Tedgin254/ENERGY-METER/README.md

# ENERGY-METER
ESP32-based smart energy monitoring system that measures voltage, current, power, and energy consumption in real time. Features Wi-Fi connectivity for cloud data logging and dashboard visualization. Ideal for home or industrial power management, energy efficiency tracking, and IoT-based smart grid applications.
energy meter
