Tedgin254/ENERGY-METER/02_Schematic_Design/energy meter.kicad_sch

## KiCad design 02_Schematic_Design/energy meter.kicad_sch (2025-10-16)

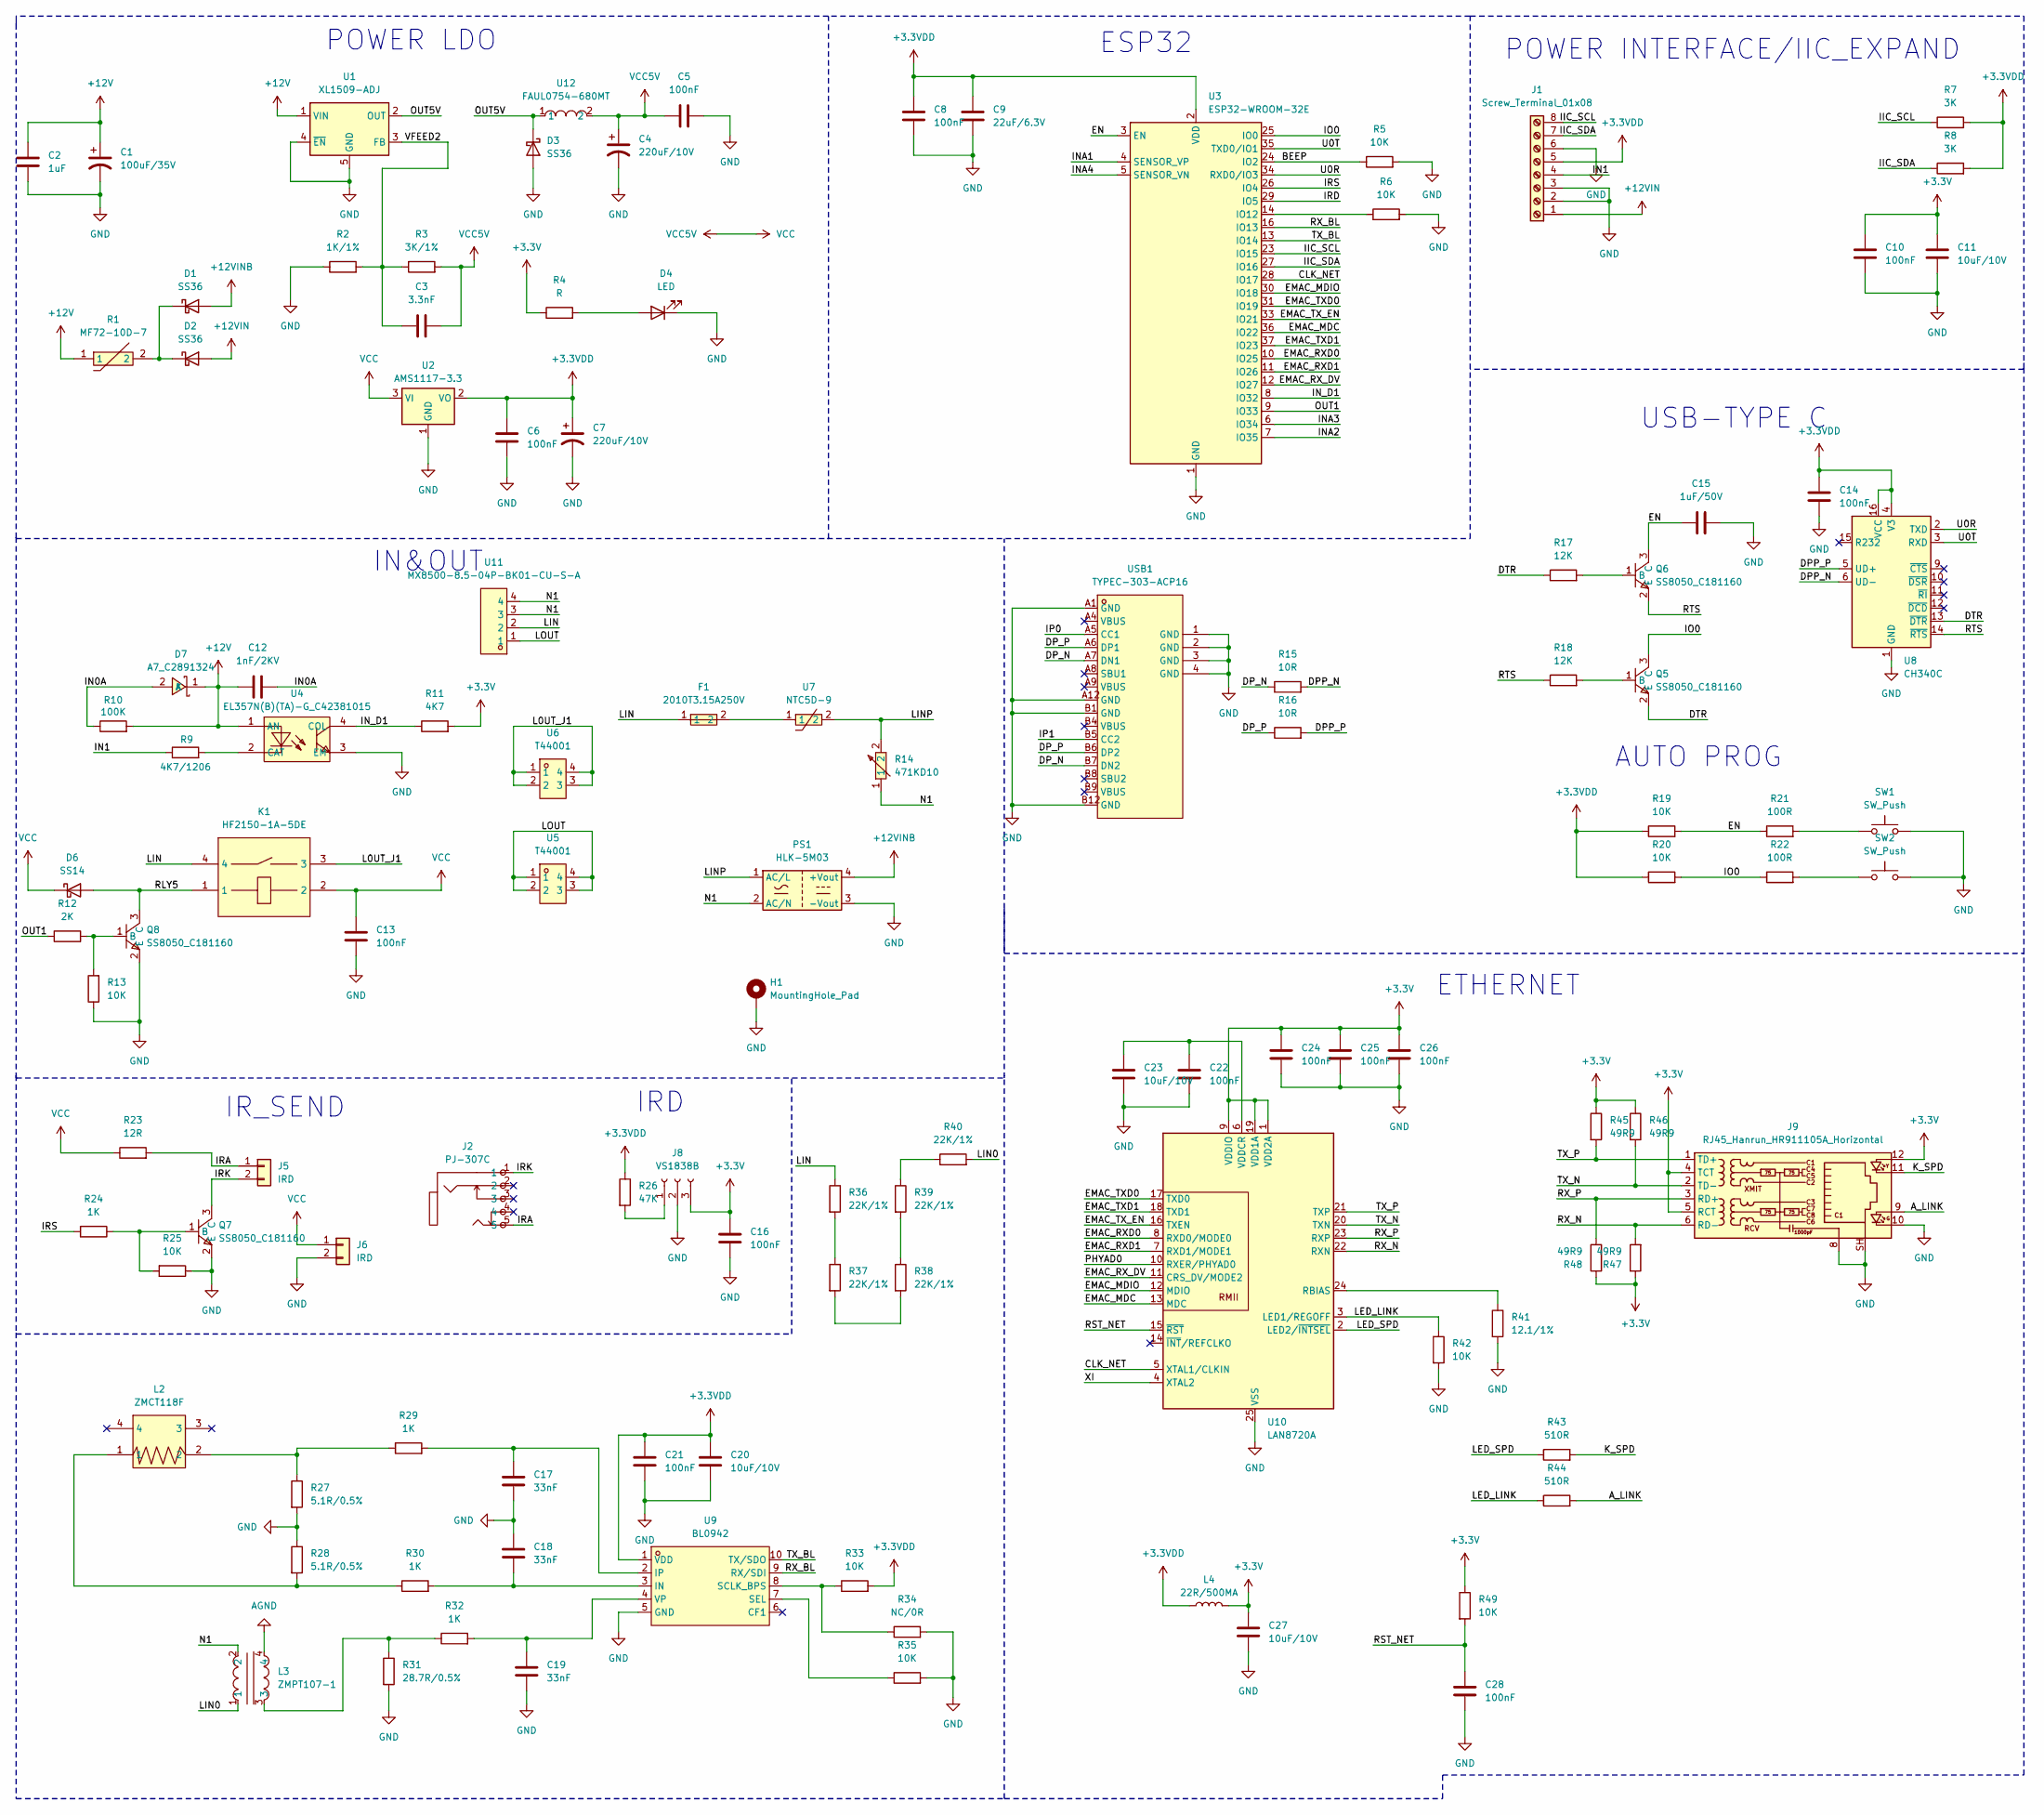
[picture p1: schematic energy meter.kicad_sch]

Parts:
C1: 100uF/35V; CP_Elec_6.3x5.7
C2: 1uF; C_0603_1608Metric_Pad1.08x0.95mm_HandSolder
C3: 3.3nF; C_0603_1608Metric
C4, C7: 220uF/10V; CP_Elec_6.3x5.7
C5, C6, C8, C10, C13, C14, C16, C21, C22, C24, C25, C26, C28: 100nF; C_0603_1608Metric
C9: 22uF/6.3V; C_0805_2012Metric
C11, C20, C23, C27: 10uF/10V; C_0805_2012Metric
C12: 1nF/2KV; C_1206_3216Metric
C15: 1uF/50V; C_0805_2012Metric
C17, C18, C19: 33nF; C_0603_1608Metric
D1, D2, D3: SS36; D_SMA
D4: LED; LED_0402_1005Metric
D6: SS14; D_SMA
D7: A7_C2891324; SOD-123FL_L2.8-W1.8-LS3.7-RD; LCSC Part C2891324
F1: 2010T3.15A250V; FUSE-TH_L8.5-W4.0-P5.08-D0.6; LCSC Part C354904
H1: MountingHole_Pad; MountingHole_2.7mm_M2.5_Pad
J1: Screw_Terminal_01x08; TerminalBlock_Phoenix_MKDS-3-8-5.08_1x08_P5.08mm_Horizontal
J2: PJ-307C; AUDIO-TH_PJ307C; LCSC Part C16684
J5, J6: IRD; TerminalBlock_Phoenix_PT-1,5-2-5.0-H_1x02_P5.00mm_Horizontal
J8: VS1838B; PinSocket_1x03_P2.54mm_Vertical
J9: RJ45_Hanrun_HR911105A_Horizontal
K1: HF2150-1A-5DE; RELAY-TH_HF2150-1A; LCSC Part C87365
L2: ZMCT118F; XFMR-TH_ZMCT118F; LCSC Part C173174
L3: ZMPT107-1; XFMR-TH_ZMPT107-1; LCSC Part C125191
L4: 22R/500MA; L_1008_2520Metric
PS1: HLK-5M03; Converter_ACDC_Hi-Link_HLK-5Mxx
Q5, Q6, Q7, Q8: SS8050_C181160; SOT-23-3_L2.9-W1.6-P1.90-LS2.8-BR; LCSC Part C181160
R1: MF72-10D-7; RES-TH_L8.5-W5.5-P5.00-D0.6-S5.50; LCSC Part C9176
R2: 1K/1%; R_0603_1608Metric
R3: 3K/1%; R_0603_1608Metric
R4: R; R_0603_1608Metric
R5, R6, R13, R19, R20, R25, R33, R35, R42, R49: 10K; R_0805_2012Metric
R7, R8: 3K; R_0603_1608Metric
R9: 4K7/1206; R_0805_2012Metric
R10: 100K; R_0805_2012Metric
R11: 4K7; R_0603_1608Metric
R12: 2K; R_0603_1608Metric
R14: 471KD10; RES-TH_L12.5-W4.8-P7.50-D1.2-S3.40; LCSC Part C78346
R15, R16: 10R; R_0603_1608Metric
R17, R18: 12K; R_0805_2012Metric
R21, R22: 100R; R_0603_1608Metric
R23: 12R; R_0603_1608Metric
R24, R29, R30, R32: 1K; R_0603_1608Metric
R26: 47K; R_0603_1608Metric
R27, R28: 5.1R/0.5%; R_0603_1608Metric
R31: 28.7R/0.5%; R_0603_1608Metric
R34: NC/0R; R_0603_1608Metric
R36, R37, R38, R39, R40: 22K/1%; R_0805_2012Metric
R41: 12.1/1%; R_0805_2012Metric
R43, R44: 510R; R_0603_1608Metric
R45, R46, R47, R48: 49R9; R_0603_1608Metric
SW1, SW2: SW_Push; SW_Tactile_SPST_NO_Straight_CK_PTS636Sx25SMTRLFS
U1: XL1509-ADJ; SOIC-8_3.9x4.9mm_P1.27mm
U2: AMS1117-3.3; SOT-223-3_TabPin2
U3: ESP32-WROOM-32E; ESP32-WROOM-32D
U4: EL357N(B)(TA)-G_C42381015; OPTO-SMD-4_L4.4-W4.1-P2.54-LS7.0-TL; LCSC Part C42381015
U5, U6: T44001; CONN-TH_T44001; LCSC Part C481447
U7: NTC5D-9; RES-TH_L11.0-W5.5-P7.50-D0.8-S4.70; LCSC Part C702818
U8: CH340C; SOIC-16_3.9x9.9mm_P1.27mm
U9: BL0942; SSOP-10_L4.9-W3.9-P1.00-LS6.0-BL; LCSC Part C2837510
U10: LAN8720A; VQFN-24-1EP_4x4mm_P0.5mm_EP2.5x2.5mm_ThermalVias
U11: MX8500-8.5-04P-BK01-CU-S-A; CONN-TH_4P-P8.50_MX8500-8.5-04P-GN01-CU-S-A; LCSC Part C5188508
U12: FAUL0754-680MT; IND-SMD_L7.9-W7.2; LCSC Part C5298270
USB1: TYPEC-303-ACP16; USB-C-SMD_TYPEC-303-ACP16; LCSC Part C720628

Connections:
+3.3V: C10.1, C11.1, C16.1, C24.1, C25.1, C26.1, C27.1, J8.3, J9.4 (TCT), J9.5 (RCT), J9.12, L4.2, R4.1, R11.2, R45.1, R46.1, R47.1, R48.1, R49.1, U10.1 (VDD2A), U10.9 (VDDIO), U10.19 (VDD1A)
+3.3VDD: C6.1, C7.1, C8.1, C9.1, C14.1, C20.1, C21.1, J1.5, L4.1, R7.2, R8.2, R19.1, R20.1, R26.1, R33.2, U2.2 (VO), U3.2 (VDD), U8.4 (V3), U8.16 (VCC), U9.1 (VDD)
+12V: C1.1, C2.1, C12.1, D7.1 (K), R1.1, R10.2, U1.1 (VIN), U4.1 (AN)
+12VIN: D2.2 (A), J1.1
+12VINB: D1.2 (A), PS1.4 (+Vout)
AGND: L3.4
A_LINK: J9.9, R44.2
BEEP: R5.1, U3.24 (IO2)
CLK_NET: U3.28 (IO17), U10.5 (XTAL1/CLKIN)
DPP_N: R15.2, U8.6 (UD-)
DPP_P: R16.2, U8.5 (UD+)
DP_N: R15.1, USB1.A7 (DN1), USB1.B7 (DN2)
DP_P: R16.1, USB1.A6 (DP1), USB1.B6 (DP2)
DTR: Q5.2 (E), R17.1, U8.13 (~DTR)
EMAC_MDC: U3.36 (IO22), U10.13 (MDC)
EMAC_MDIO: U3.30 (IO18), U10.12 (MDIO)
EMAC_RXD0: U3.10 (IO25), U10.8 (RXD0/MODE0)
EMAC_RXD1: U3.11 (IO26), U10.7 (RXD1/MODE1)
EMAC_RX_DV: U3.12 (IO27), U10.11 (CRS_DV/MODE2)
EMAC_TXD0: U3.31 (IO19), U10.17 (TXD0)
EMAC_TXD1: U3.37 (IO23), U10.18 (TXD1)
EMAC_TX_EN: U3.33 (IO21), U10.16 (TXEN)
EN: C15.1, Q6.3 (C), R19.2, R21.1, U3.3 (EN)
GND: C1.2, C2.2, C4.2, C5.2, C6.2, C7.2, C8.2, C9.2, C10.2, C11.2, C13.2, C14.2, C15.2, C16.2, C17.2, C18.1, C19.2, C20.2, C21.2, C22.2, C23.2, C24.2, C25.2, C26.2, C27.2, C28.2, D3.2 (A), D4.1 (K), H1.1, J1.2, J1.3, J1.6, J6.2, J8.2, J9.8, J9.10, J9.SH, PS1.3 (-Vout), Q7.2 (E), Q8.2 (E), R2.1, R5.2, R6.2, R13.1, R25.1, R27.2, R28.1, R31.2, R34.2, R35.2, R41.2, R42.2, SW1.2, SW2.2, U1.4 (~EN), U1.5 (GND), U1.6 (GND), U1.7 (GND), U1.8 (GND), U2.1 (GND), U3.1 (GND), U3.15 (GND), U3.38 (GND), U3.39 (GND), U4.3 (EM), U8.1 (GND), U9.5 (GND), U10.25 (VSS), USB1.1 (GND), USB1.2 (GND), USB1.3 (GND), USB1.4 (GND), USB1.A1 (GND), USB1.A12 (GND), USB1.B1 (GND), USB1.B12 (GND)
IIC_SCL: J1.8, R7.1, U3.23 (IO15)
IIC_SDA: J1.7, R8.1, U3.27 (IO16)
IN0A: C12.2, D7.2 (A), R10.1
IN1: J1.4, R9.1
INA1: U3.4 (SENSOR_VP)
INA2: U3.7 (IO35)
INA3: U3.6 (IO34)
INA4: U3.5 (SENSOR_VN)
IN_D1: R11.1, U3.8 (IO32), U4.4 (COL)
IO0: Q5.3 (C), R20.2, R22.1, U3.25 (IO0)
IP0: USB1.A5 (CC1)
IP1: USB1.B5 (CC2)
IRA: J2.5, J5.1, R23.2
IRD: U3.29 (IO5)
IRK: J2.1, J5.2, Q7.3 (C)
IRS: R24.2, U3.26 (IO4)
K_SPD: J9.11, R43.2
L0UT_J1: K1.3, U6.1, U6.2, U6.3, U6.4
LED_LINK: R42.1, R44.1, U10.3 (LED1/REGOFF)
LED_SPD: R43.1, U10.2 (LED2/~INTSEL)
LIN: F1.1, K1.4, R36.1, U11.2
LIN0: L3.1, R40.2
LINP: PS1.1 (AC/L), R14.2, U7.2
LOUT: U5.1, U5.2, U5.3, U5.4, U11.1
N1: L3.2, PS1.2 (AC/N), R14.1, U11.3, U11.4
unnamed: C17.1, R29.2, U9.2 (IP)
unnamed: C18.2, R30.2, U9.3 (IN)
unnamed: C19.1, R32.2, U9.4 (VP)
unnamed: C22.1, C23.1, U10.6 (VDDCR)
unnamed: D1.1 (K), D2.1 (K), R1.2
unnamed: D4.2 (A), R4.2
unnamed: F1.2, U7.1
unnamed: J8.1, R26.2
unnamed: L2.1, R28.2, R30.1
unnamed: L2.2, R27.1, R29.1
unnamed: L3.3, R31.1, R32.1
unnamed: Q5.1 (B), R18.2
unnamed: Q6.1 (B), R17.2
unnamed: Q7.1 (B), R24.1, R25.2
unnamed: Q8.1 (B), R12.2, R13.2
unnamed: R6.1, U3.14 (IO12)
unnamed: R9.2, U4.2 (CAT)
unnamed: R21.2, SW1.1
unnamed: R22.2, SW2.1
unnamed: R33.1, R34.1, U9.8 (SCLK_BPS)
unnamed: R35.1, U9.7 (SEL)
unnamed: R36.2, R37.1
unnamed: R37.2, R38.2
unnamed: R38.1, R39.2
unnamed: R39.1, R40.1
unnamed: R41.1, U10.24 (RBIAS)
OUT1: R12.1, U3.9 (IO33)
OUT5V: D3.1 (K), U1.2 (OUT), U12.1
PHYAD0: U10.10 (RXER/PHYAD0)
RLY5: D6.2 (A), K1.1, Q8.3 (C)
RST_NET: C28.1, R49.2, U10.15 (~RST)
RTS: Q6.2 (E), R18.1, U8.14 (~RTS)
RX_BL: U3.16 (IO13), U9.9 (RX/SDI)
RX_N: J9.6 (RD-), R47.2, U10.22 (RXN)
RX_P: J9.3 (RD+), R48.2, U10.23 (RXP)
TX_BL: U3.13 (IO14), U9.10 (TX/SDO)
TX_N: J9.2 (TD-), R46.2, U10.20 (TXN)
TX_P: J9.1 (TD+), R45.2, U10.21 (TXP)
U0R: U3.34 (RXD0/IO3), U8.2 (TXD)
U0T: U3.35 (TXD0/IO1), U8.3 (RXD)
VCC: C3.2, C4.1, C5.1, C13.1, D6.1 (K), J6.1, K1.2, R3.2, R23.1, U2.3 (VI), U12.2
VFEED2: C3.1, R2.2, R3.1, U1.3 (FB)
XI: U10.4 (XTAL2)

Notes on the sheet:
POWER LDO
AUTO PROG
POWER INTERFACE/IIC_EXPAND
IRD
ETHERNET
USB-TYPE C
IR_SEND
ESP32
IN&OUT
